Airrr17/LoRa_messenger/pics/full_sch.png

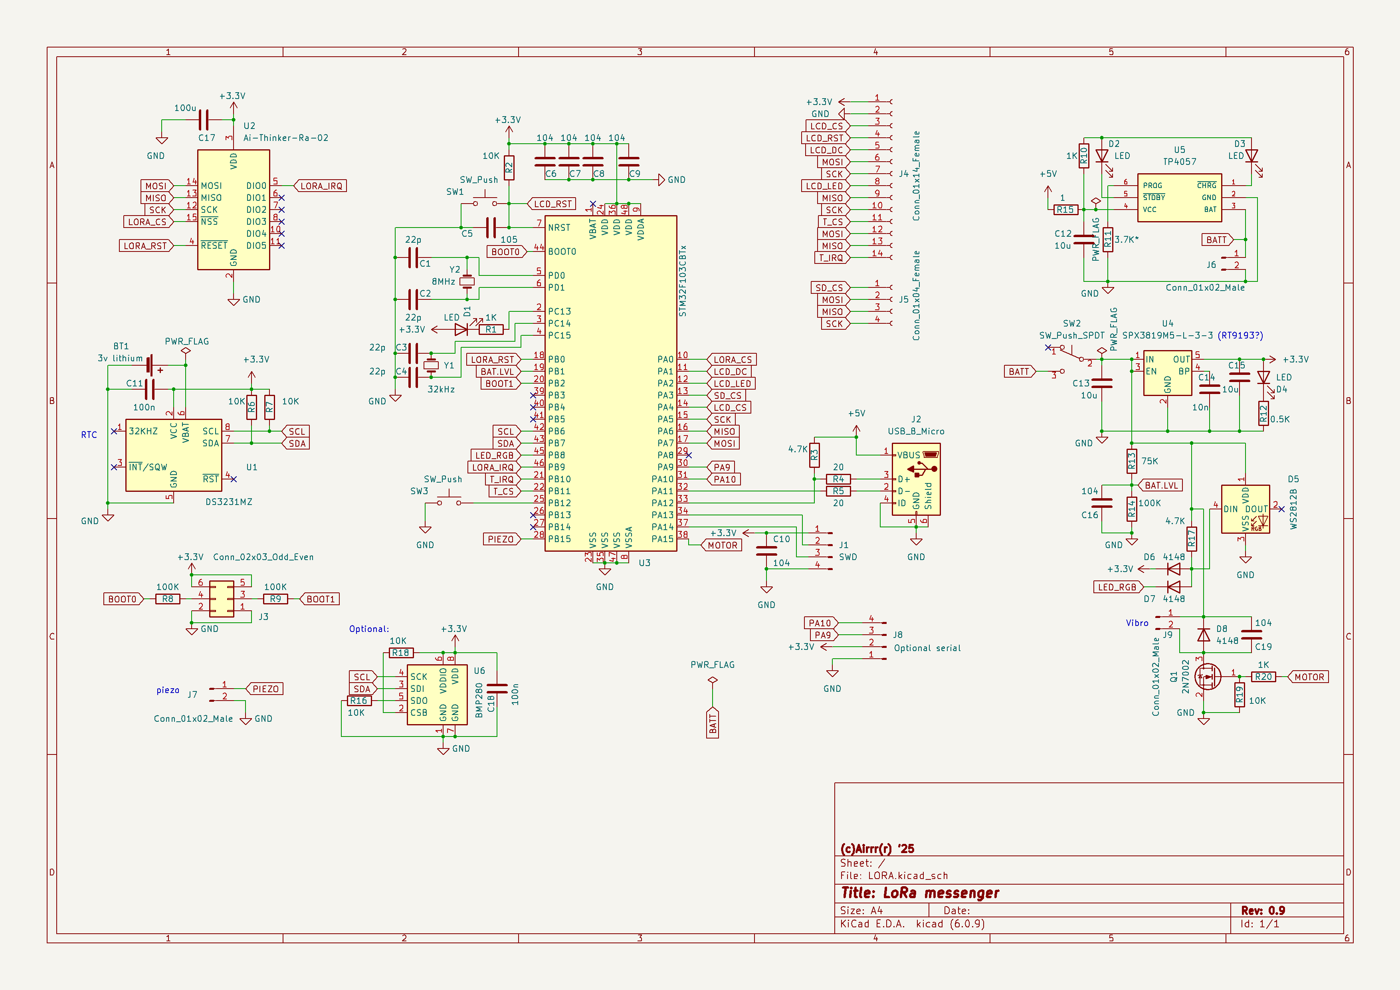
pics/full_sch.png
