Airrr17/LoRa_messenger/(threads)

Thread 2 (2021-01-17):

Compilation errors

merinsTDL, 2021-01-17:
Cool project!
For me the compilation fails with errors quite similar. A problem for AdafruitI2C to use the stm32duino Wire library.
```
error: invalid conversion from 'const uint8_t* {aka const unsigned char*}' to 'uint8* {aka unsigned char*}' [-fpermissive]
     if (_wire->write(prefix_buffer, prefix_len) != prefix_len) {

In file included from /Arduino15/packages/stm32duino/hardware/STM32F1/2020.12.26/libraries/Wire/Wire.h:42:0,
                 from /Arduino/libraries/Adafruit_BusIO/Adafruit_I2CDevice.h:1,
                 from /Arduino/libraries/Adafruit_BusIO/Adafruit_I2CDevice.cpp:1:
/Arduino15/packages/stm32duino/hardware/STM32F1/2020.12.26/libraries/Wire/utility/WireBase.h:123:12: error:   initializing argument 1 of 'size_t WireBase::write(uint8*, int)' [-fpermissive]
     size_t write(uint8*, int);
```

Closed 2021-01-17.
